e2e4-1/Arduino_VU_Meter_2020/Arduino_VU_Meter_2020_Display_Schema.png

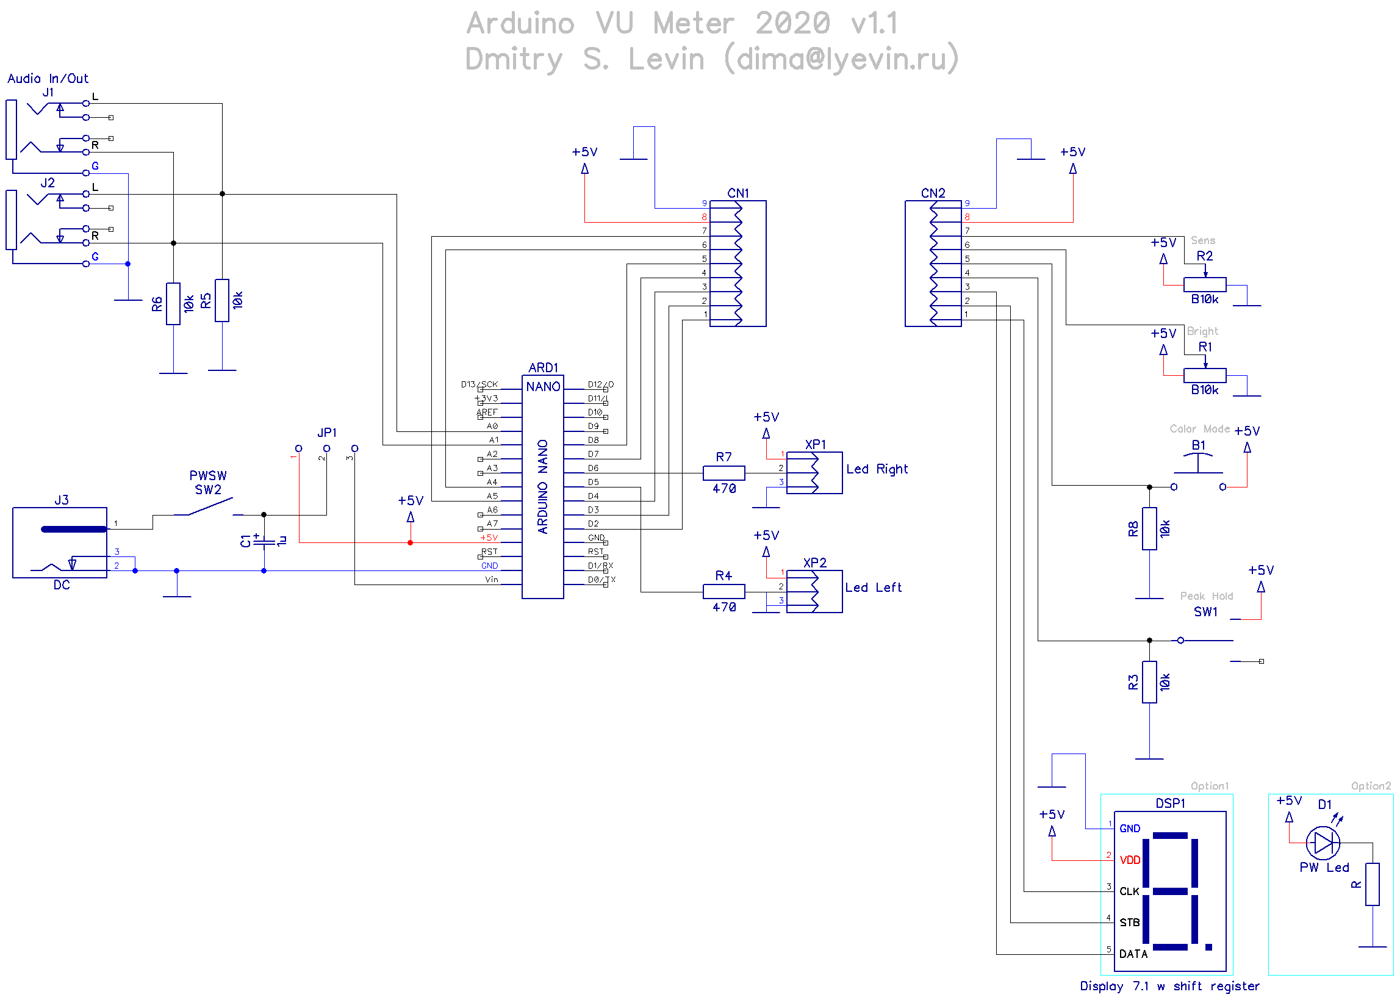
Arduino_VU_Meter_2020_Display_Schema.png
