e2e4-1/Arduino_VU_Meter_2020/Arduino_VU_Meter_2020_DS_CD4094B_Schema.png

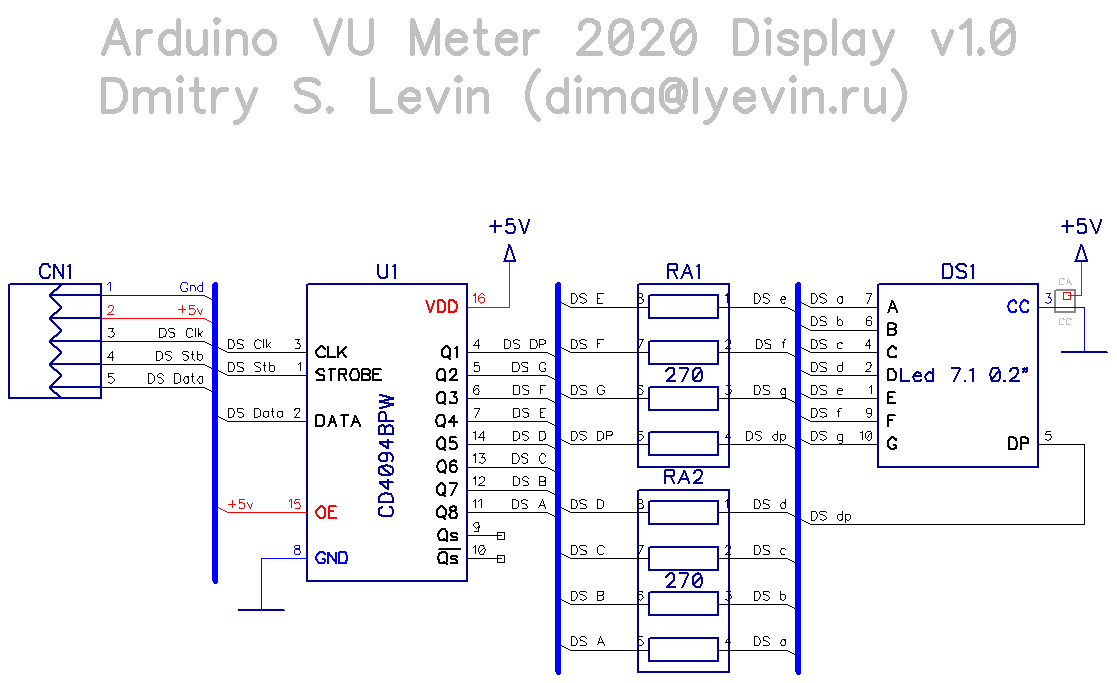
Arduino_VU_Meter_2020_DS_CD4094B_Schema.png
