e2e4-1/Arduino_VU_Meter_2020/(commit log)

2024-05-17 Add files via upload
    Version 1.0
    - Add 24 led 2 strips
    - Adopt setup value
    - Change Color Schemas
2024-05-17 Add files via upload
    Version 1.1
    - Add auto change color scheme for Button1 pressed > 1sec (req arduino-timer-api library).
    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
2024-05-17 Add files via upload
    Version 1.2
    - Store color settings in EEPROM (req EEPROM library).
    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
2024-05-17 Add files via upload
    Version 1.3
    - Add 7.1 segment numeric display
    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
